s21rc/auto-STL-controller/S21RC STL controller Sch_schem.jpg

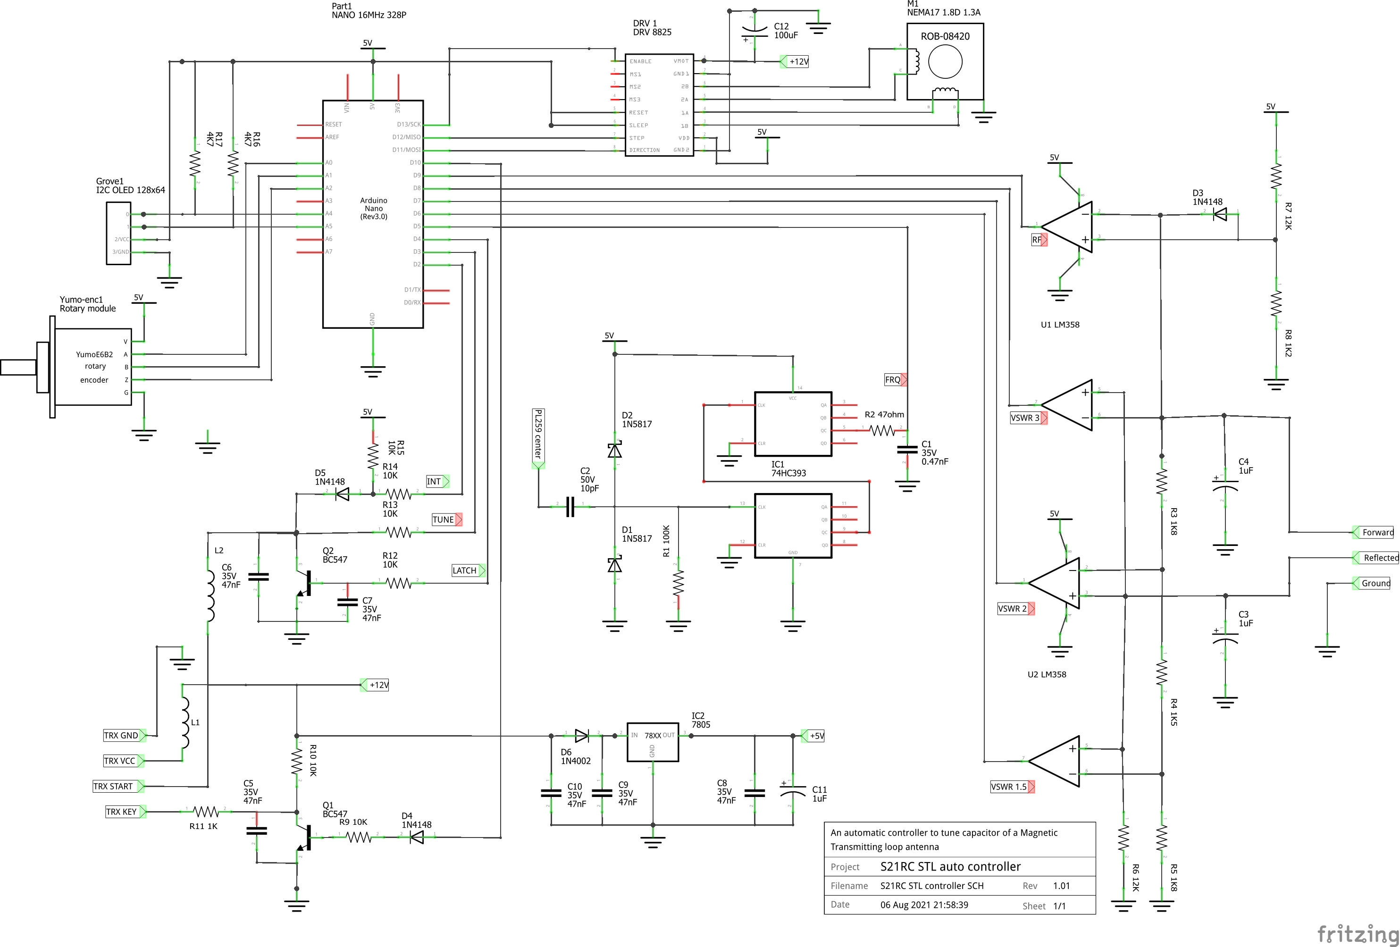
S21RC STL controller Sch_schem.jpg
